xesscorp/StickIt-SmallButtons/docs/pages/index.md

---
title: StickIt! SmallButtons Module
keywords: homepage
sidebar: manual_sidebar
permalink: index.html
summary: Manual coverpage for the StickIt! SmallButtons Module.
---



{% include links.html %}
