xesscorp/StickIt-SmallButtons/docs/images/PCB.png

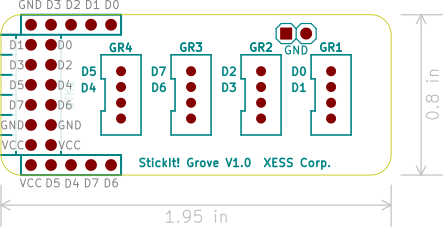
docs/images/PCB.png
