xesscorp/StickIt-SmallButtons/docs/images/pinout.jpg

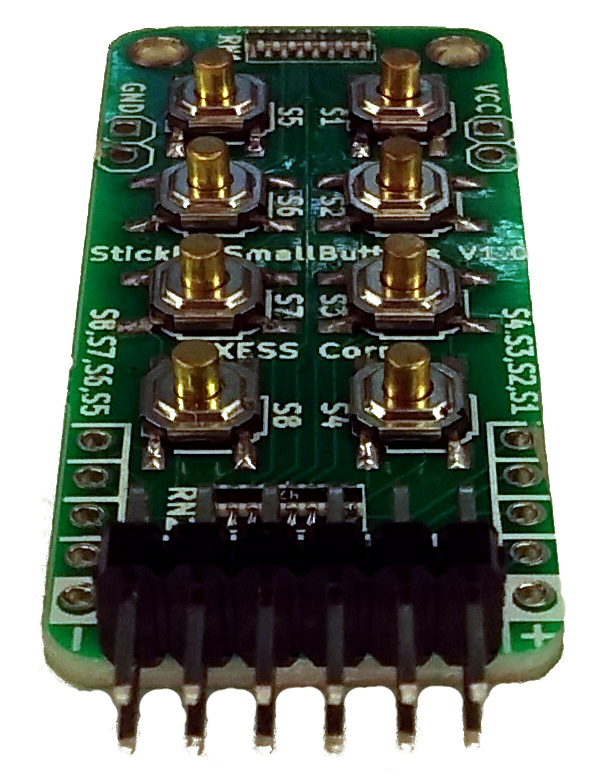
docs/images/pinout.jpg
