xesscorp/StickIt-SmallButtons/docs/images/schematic.png

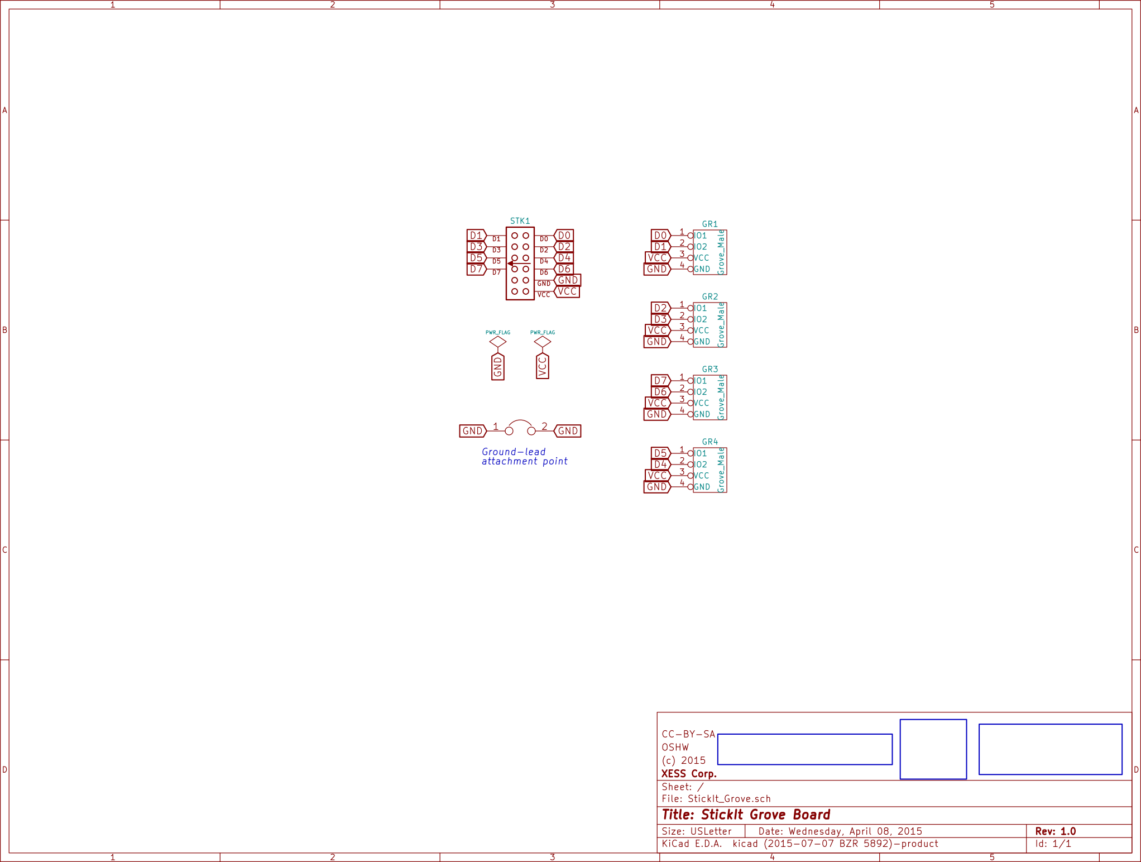
docs/images/schematic.png
