xesscorp/StickIt-SmallButtons/docs/pages/setup.md

---
title: Setup
keywords: setup
sidebar: manual_sidebar
permalink: setup.html
summary: How to setup the module with a breadboard or a PMOD interface.
---

The {{site.product_name}} provides an array of eight pushbuttons that you can insert
into an eight-bit PMOD&trade; socket (such as the ones on a [{{site.stickit_mb}}](http://www.xess.com/shop/product/stickit-mb-4_0/))
or a standard solderless breadboard.

## Inserting Your Module Into a PMOD Socket

To use the {{product_name}} with a PMOD socket, first solder the included
male PMOD header to the module as shown:

{{site.product_name}} with PMOD header attached.

Then insert the module into a PMOD socket such as the ones on the {{site.stickit_mb}}:

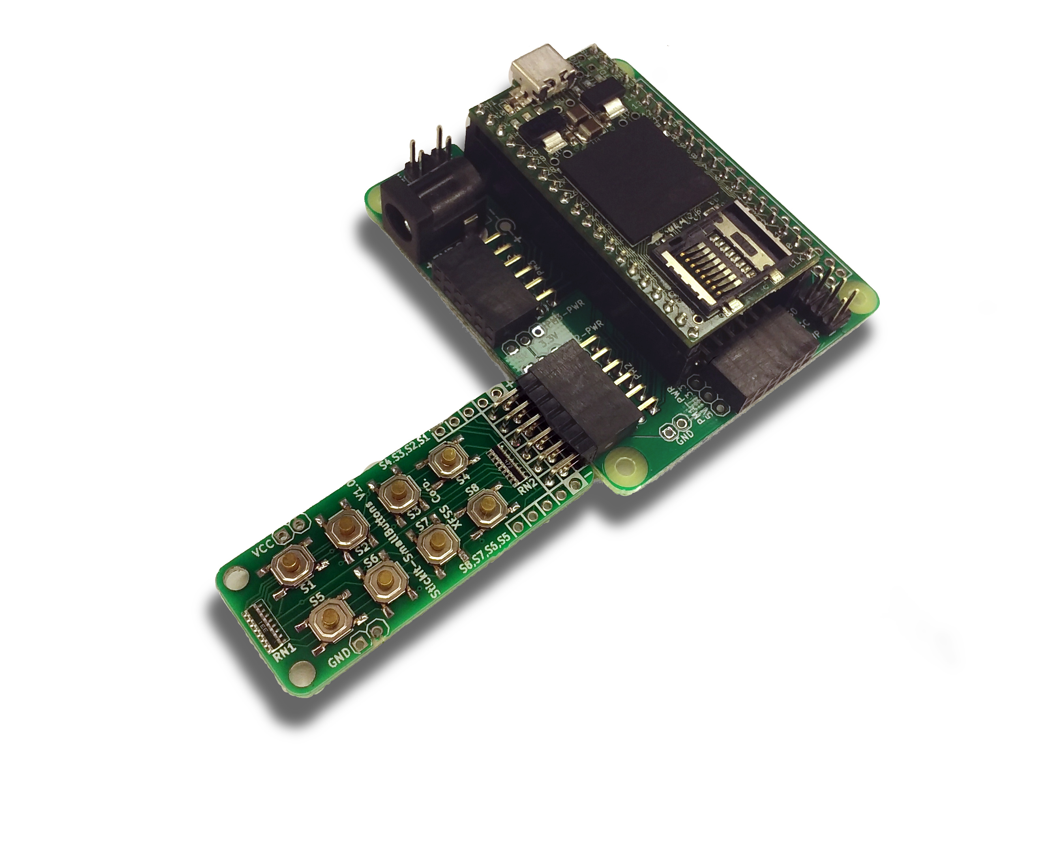
[picture p7: docs/Manual/pics/StickIt-mating.jpg]
{{site.product_name}} inserted into a PMOD socket.


## Inserting Your Module Into a Solderless Breadboard

To use the {{site.product_name}} with a solderless breadboard, first solder the two included
5&times;1 headers to the module as shown:

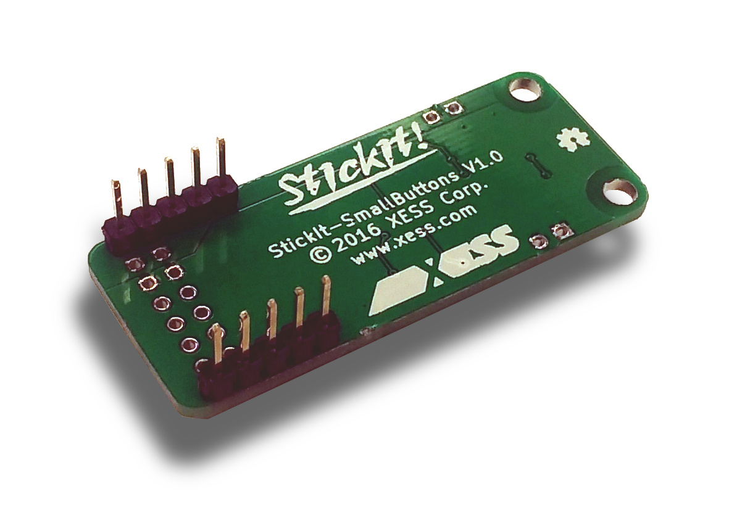
[picture p8: docs/Manual/pics/breadboard-pins.jpg]
{{site.product_name}} with 5×1 headers attached.


Then insert the module into the breadboard and make connections to it:

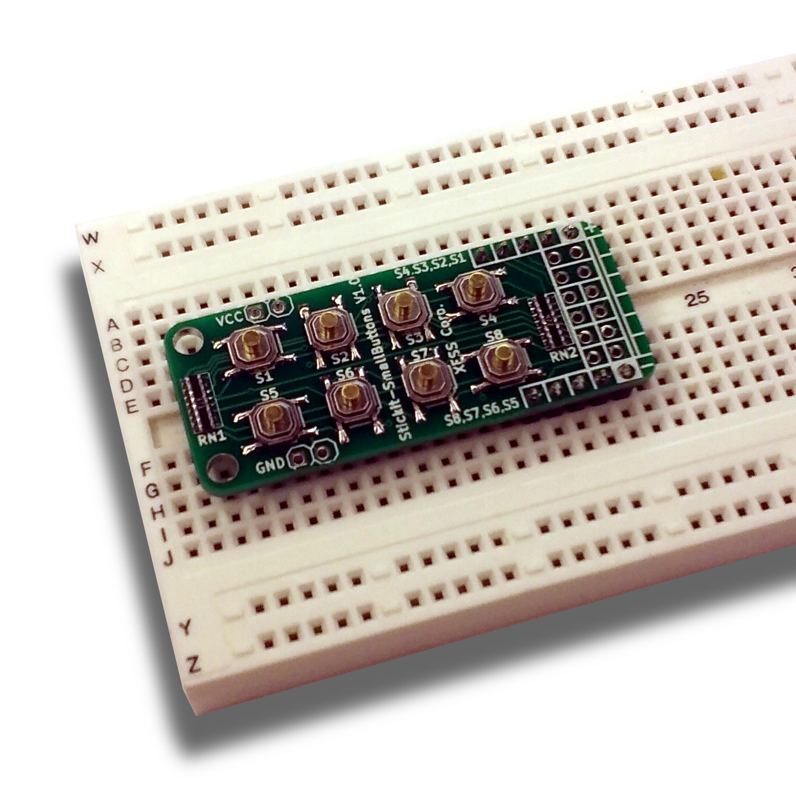
[picture p9: docs/Manual/pics/breadboard-mating.jpg]
{{site.product_name}} inserted into a solderless breadboard.


{% include links.html %}
