xesscorp/StickIt-SmallButtons/(commit log)

2016-05-11 Initial checkin.
    [StickIt-SmallButtons.kicad_pcb, StickIt-SmallButtons.sch]
2016-05-14 Changed StickIt connector signal labeling.
    [StickIt-SmallButtons.kicad_pcb, StickIt-SmallButtons.sch]
2016-05-28 Added part numbers, pricing information, and component doc links.
    [StickIt-SmallButtons.kicad_pcb, StickIt-SmallButtons.sch]
2016-06-10 Added FPGA design for testing SmallButtons module.
    [StickIt-SmallButtons.sch]
2016-11-03 Changed pullup resistors from 1K to 330 ohms. * Changed link to tact pushbutton page on Aliexpress.
    [StickIt-SmallButtons.sch]
2016-11-05 Fixed link to schematic.
2016-11-05 Moved schematic.pdf to misc directory. * Modified sidebar.html so it doesn't remove "/" from url fields. * topnav.html no longer needs special handling for the link to the main repo. * Link to main r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
2016-11-05 Changed link to schematic in main repo README.'
